SurrealityLabs/pi400-keyboard/README.md

# pi400-keyboard
A mechanical QWERTY keyboard for the Raspberry Pi 400
