SurrealityLabs/pi400-keyboard/10554668.png

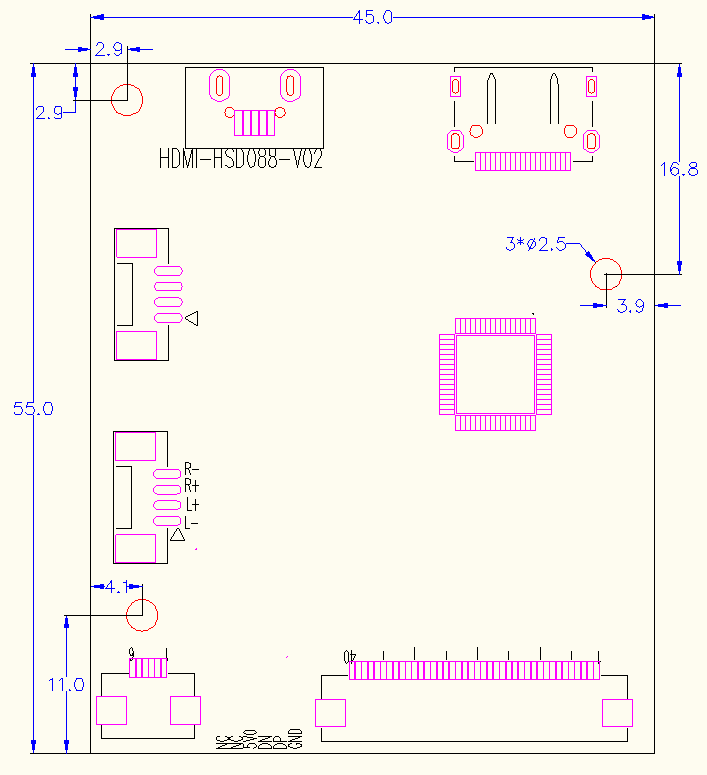
10554668.png
