SurrealityLabs/pi400-keyboard/keyboard-layout-xt.jpg

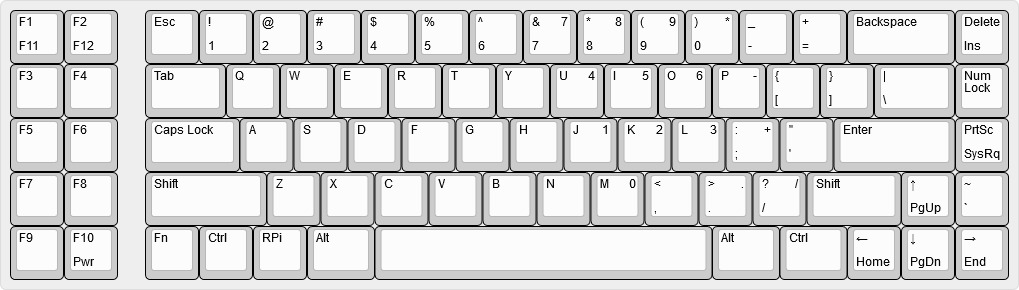
keyboard-layout-xt.jpg
