SurrealityLabs/pi400-keyboard/keyboard-layout.png

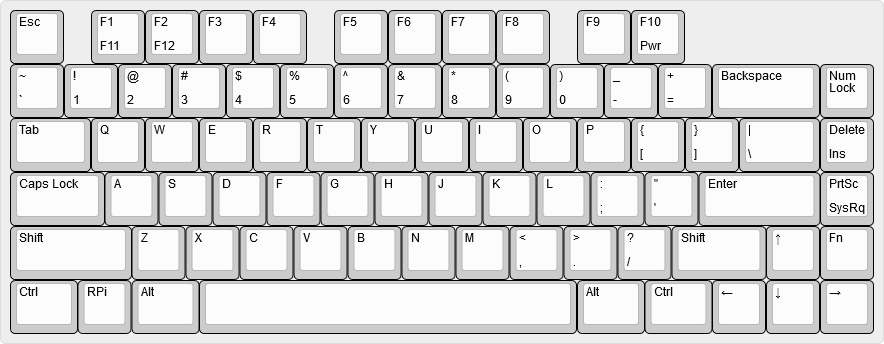
keyboard-layout.png
