SurrealityLabs/pi400-keyboard/pi400 keyboard matrix.png

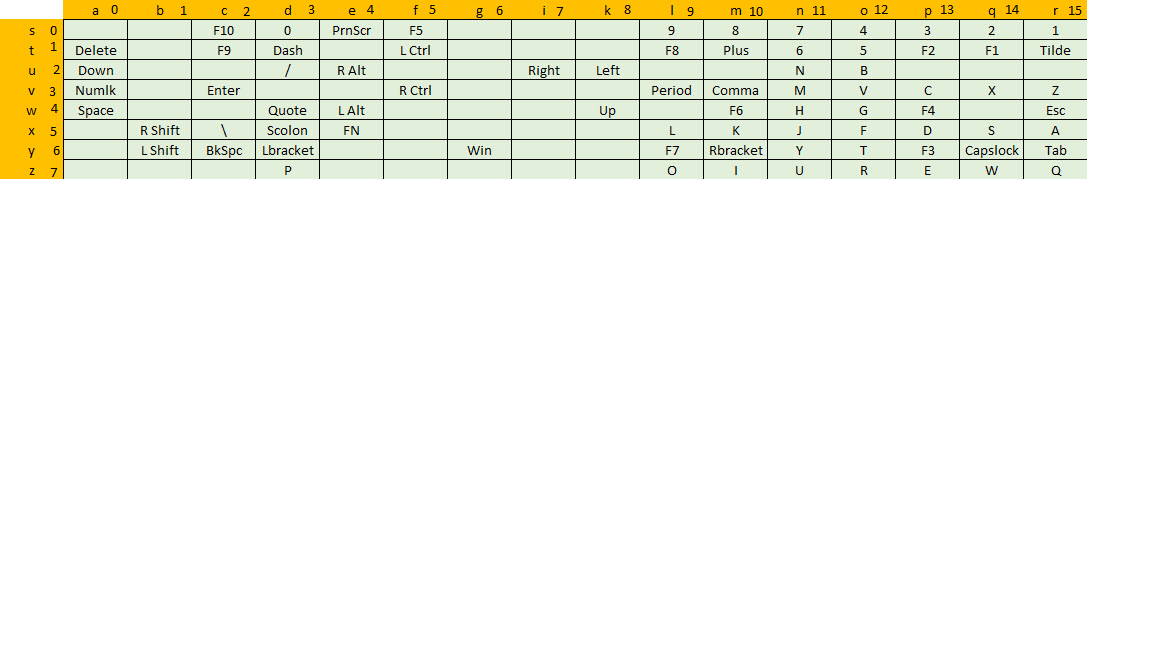
pi400 keyboard matrix.png
