SurrealityLabs/pi400-keyboard/s-l1600.jpg

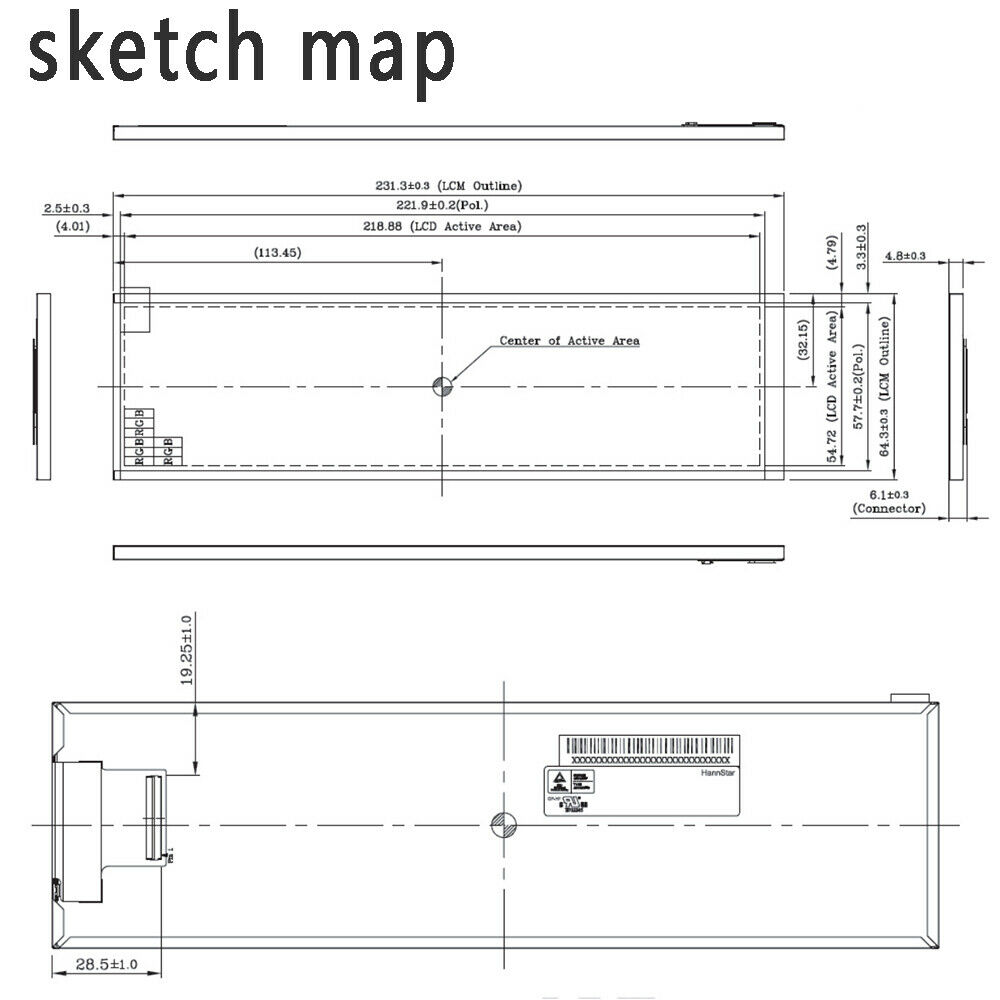
s-l1600.jpg
