SurrealityLabs/pi400-keyboard/keyboard-test/keyboard-test.kicad_pcb

## KiCad design keyboard-test/keyboard-test.kicad_pcb (2025-02-03)

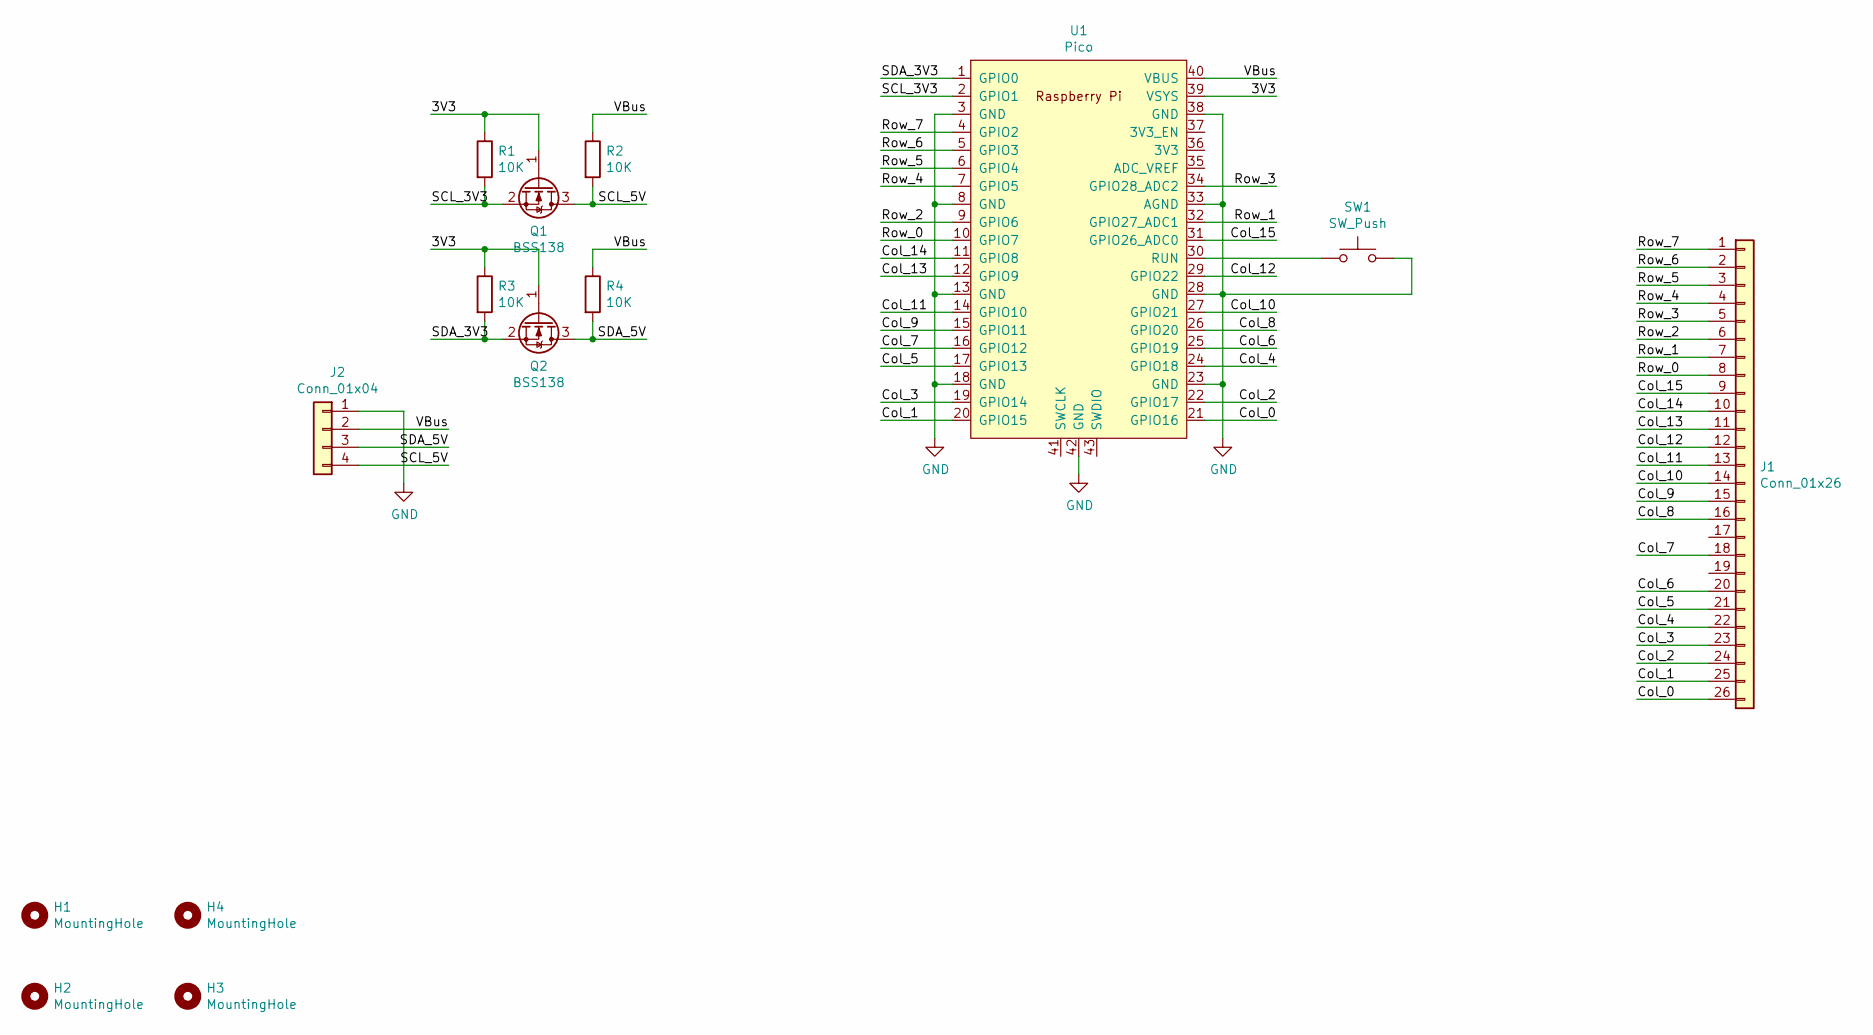
[picture p6: schematic keyboard-test.sch]

Parts:
H1, H2, H3, H4: MountingHole; MountingHole_3.2mm_M3_DIN965
J1: Conn_01x26; TE_2-84952-6_1x26-1MP_P1.0mm_Horizontal
J2: Conn_01x04; JST_PH_S4B-PH-SM4-TB_1x04-1MP_P2.00mm_Horizontal
Q1, Q2: BSS138; SOT-23
R1, R2, R3, R4: 10K; R_0603_1608Metric
SW1: SW_Push; SW_PUSH_6mm
U1: Pico; RPi_Pico_SMD_TH

Connections:
/3V3: Q1.1 (G), Q2.1 (G), R1.1, R3.1, U1.39 (VSYS)
/Col_0: J1.26, U1.21 (GPIO16)
/Col_1: J1.25, U1.20 (GPIO15)
/Col_2: J1.24, U1.22 (GPIO17)
/Col_3: J1.23, U1.19 (GPIO14)
/Col_4: J1.22, U1.24 (GPIO18)
/Col_5: J1.21, U1.17 (GPIO13)
/Col_6: J1.20, U1.25 (GPIO19)
/Col_7: J1.18, U1.16 (GPIO12)
/Col_8: J1.16, U1.26 (GPIO20)
/Col_9: J1.15, U1.15 (GPIO11)
/Col_10: J1.14, U1.27 (GPIO21)
/Col_11: J1.13, U1.14 (GPIO10)
/Col_12: J1.12, U1.29 (GPIO22)
/Col_13: J1.11, U1.12 (GPIO9)
/Col_14: J1.10, U1.11 (GPIO8)
/Col_15: J1.9, U1.31 (GPIO26_ADC0)
/Row_0: J1.8, U1.10 (GPIO7)
/Row_1: J1.7, U1.32 (GPIO27_ADC1)
/Row_2: J1.6, U1.9 (GPIO6)
/Row_3: J1.5, U1.34 (GPIO28_ADC2)
/Row_4: J1.4, U1.7 (GPIO5)
/Row_5: J1.3, U1.6 (GPIO4)
/Row_6: J1.2, U1.5 (GPIO3)
/Row_7: J1.1, U1.4 (GPIO2)
/SCL_3V3: Q1.2 (S), R1.2, U1.2 (GPIO1)
/SCL_5V: J2.4, Q1.3 (D), R2.2
/SDA_3V3: Q2.2 (S), R3.2, U1.1 (GPIO0)
/SDA_5V: J2.3, Q2.3 (D), R4.2
/VBus: J2.2, R2.1, R4.1, U1.40 (VBUS)
GND: J2.1, SW1.2, U1.3 (GND), U1.8 (GND), U1.13 (GND), U1.18 (GND), U1.23 (GND), U1.28 (GND), U1.33 (AGND), U1.38 (GND), U1.42 (GND)
unnamed: SW1.1, U1.30 (RUN)

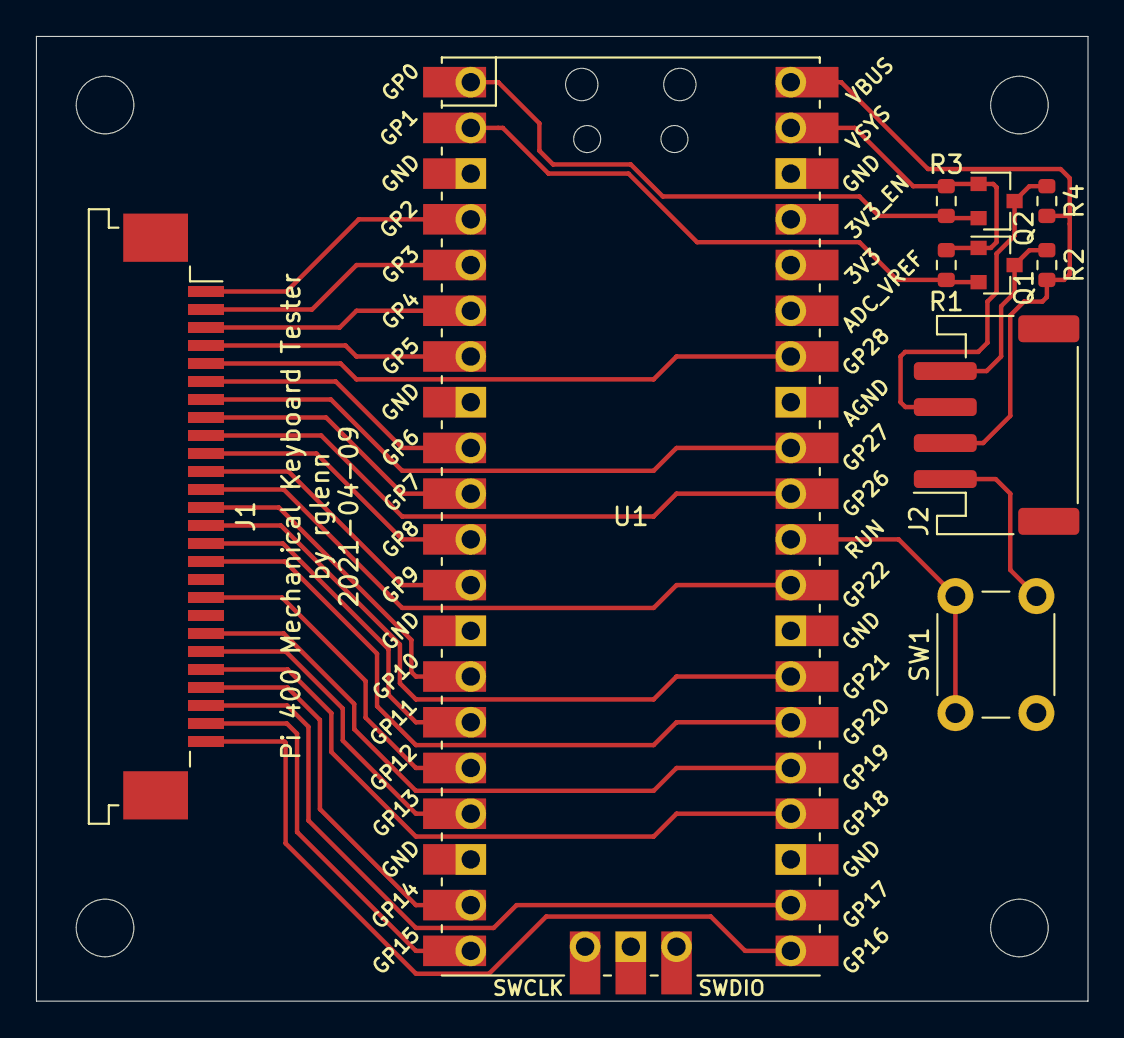
[picture p7: board keyboard-test.kicad_pcb from above]

Board: 2 copper layers, 58.4 x 53.6 mm, 14 parts (0 on the bottom side), 32 nets.
