SurrealityLabs/pi400-keyboard/keyboard-layout-tall/keyboard-layout-tall.kicad_pcb

## KiCad design keyboard-layout-tall/keyboard-layout-tall.kicad_pcb (2021-05-15)

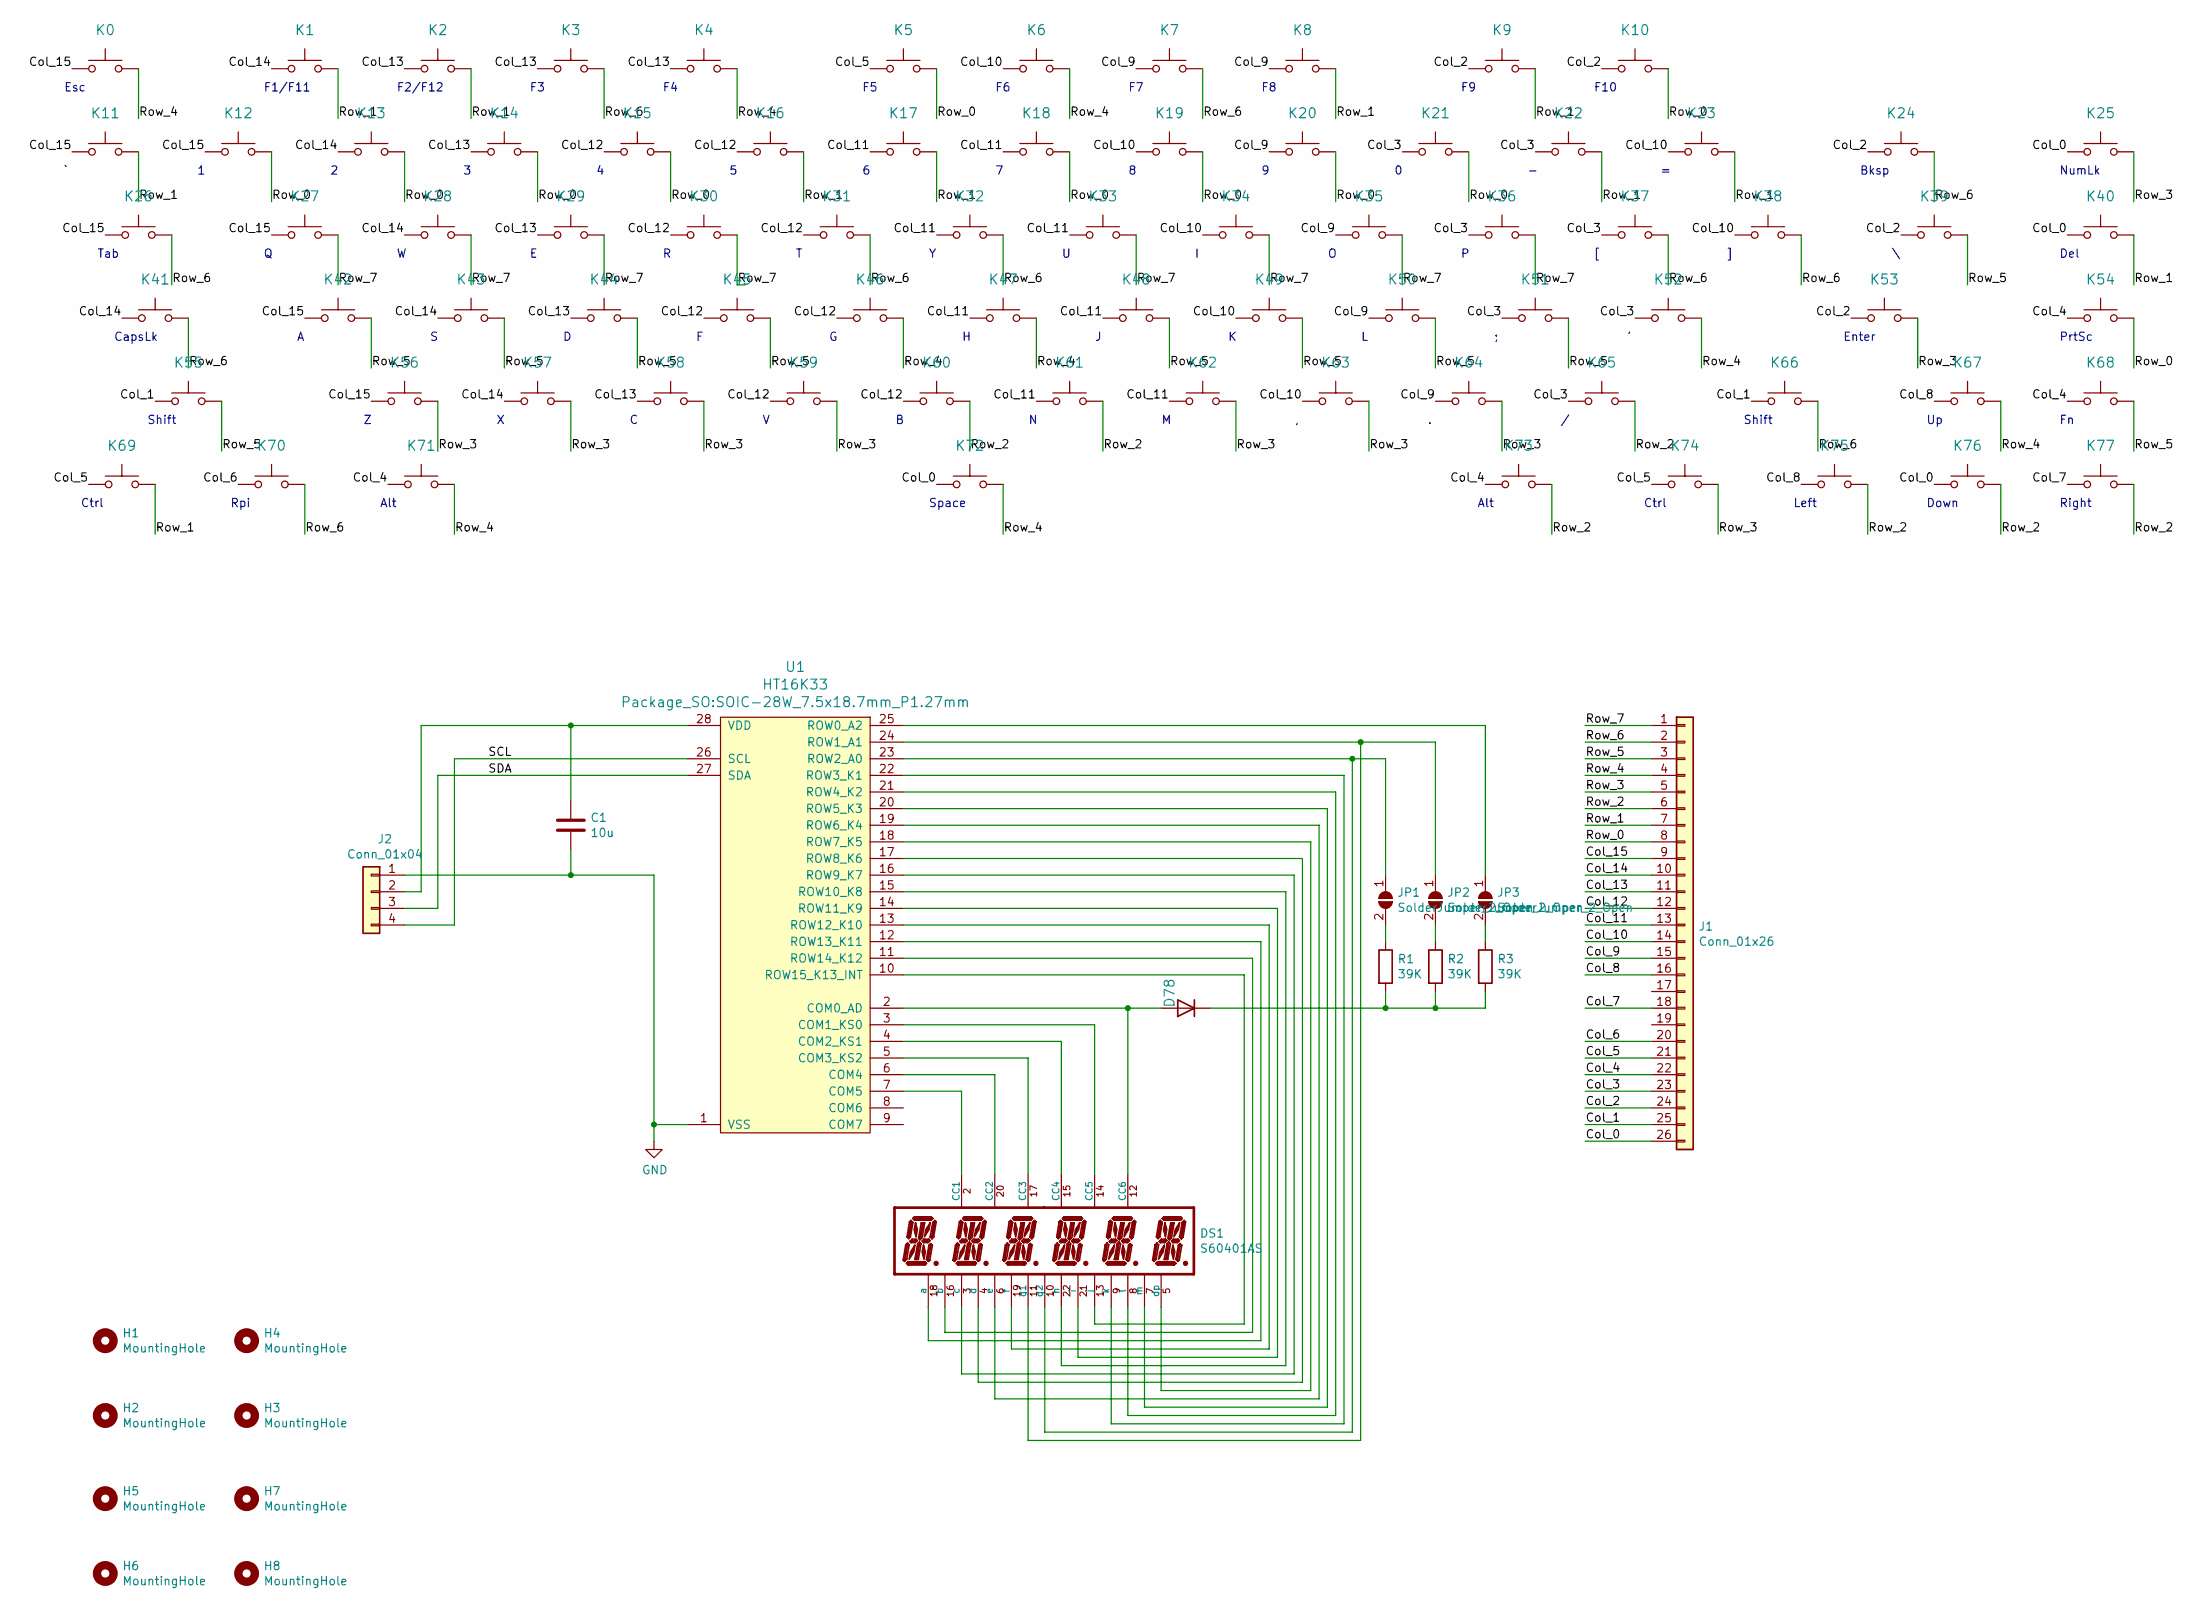
[picture p8: schematic keyboard-layout-tall.sch]

Parts:
C1: 10u; C_0805_2012Metric; LCSC C15850
D78: D; D_SOD-123F; LCSC C64898
DS1: S60401AS
H1, H2, H3, H4, H5, H6, H7, H8: MountingHole; MountingHole_3.2mm_M3_DIN965
J1: Conn_01x26; TE_2-84952-6_1x26-1MP_P1.0mm_Horizontal
J2: Conn_01x04; JST_PH_S4B-PH-SM4-TB_1x04-1MP_P2.00mm_Horizontal
JP1, JP2, JP3: SolderJumper_2_Open; SolderJumper-2_P1.3mm_Open_RoundedPad1.0x1.5mm
K0, K1, K2, K3, K4, K5, K6, K7, K8, K9, K10, K11, K12, K13, K14, K15, K16, K17, K18, K19, K20, K21, K22, K23, K25, K27, K28, K29, K30, K31, K32, K33, K34, K35, K36, K37, K38, K40, K42, K43, K44, K45, K46, K47, K48, K49, K50, K51, K52, K54, K56, K57, K58, K59, K60, K61, K62, K63, K64, K65, K67, K68, K70, K75, K76, K77: KEYSW; SW_Cherry_MX_1.00u_PCB
K24: KEYSW; SW_Cherry_MX_2.00u_PCB
K26, K39: KEYSW; SW_Cherry_MX_1.50u_PCB
K41, K66: KEYSW; SW_Cherry_MX_1.75u_PCB
K53, K55: KEYSW; SW_Cherry_MX_2.25u_PCB
K69, K71, K73, K74: KEYSW; SW_Cherry_MX_1.25u_PCB
K72: KEYSW; SW_Cherry_MX_7u_PCB
R1, R2, R3: 39K; R_0603_1608Metric; LCSC C23153
U1: HT16K33; SOIC-28W_7.5x18.7mm_P1.27mm

Connections:
/Col_0: J1.26, K25.1, K40.1, K72.1, K76.1
/Col_1: J1.25, K55.1, K66.1
/Col_2: J1.24, K9.1, K10.1, K24.1, K39.1, K53.1
/Col_3: J1.23, K21.1, K22.1, K36.1, K37.1, K51.1, K52.1, K65.1
/Col_4: J1.22, K54.1, K68.1, K71.1, K73.1
/Col_5: J1.21, K5.1, K69.1, K74.1
/Col_6: J1.20, K70.1
/Col_7: J1.18, K77.1
/Col_8: J1.16, K67.1, K75.1
/Col_9: J1.15, K7.1, K8.1, K20.1, K35.1, K50.1, K64.1
/Col_10: J1.14, K6.1, K19.1, K23.1, K34.1, K38.1, K49.1, K63.1
/Col_11: J1.13, K17.1, K18.1, K32.1, K33.1, K47.1, K48.1, K61.1, K62.1
/Col_12: J1.12, K15.1, K16.1, K30.1, K31.1, K45.1, K46.1, K59.1, K60.1
/Col_13: J1.11, K2.1, K3.1, K4.1, K14.1, K29.1, K44.1, K58.1
/Col_14: J1.10, K1.1, K13.1, K28.1, K41.1, K43.1, K57.1
/Col_15: J1.9, K0.1, K11.1, K12.1, K26.1, K27.1, K42.1, K56.1
/Row_0: J1.8, K5.2, K10.2, K12.2, K13.2, K14.2, K15.2, K18.2, K19.2, K20.2, K21.2, K54.2
/Row_1: J1.7, K1.2, K2.2, K8.2, K9.2, K11.2, K16.2, K17.2, K22.2, K23.2, K40.2, K69.2
/Row_2: J1.6, K60.2, K61.2, K65.2, K73.2, K75.2, K76.2, K77.2
/Row_3: J1.5, K25.2, K53.2, K56.2, K57.2, K58.2, K59.2, K62.2, K63.2, K64.2, K74.2
/Row_4: J1.4, K0.2, K4.2, K6.2, K46.2, K47.2, K52.2, K67.2, K71.2, K72.2
/Row_5: J1.3, K39.2, K42.2, K43.2, K44.2, K45.2, K48.2, K49.2, K50.2, K51.2, K55.2, K68.2
/Row_6: J1.2, K3.2, K7.2, K24.2, K26.2, K31.2, K32.2, K37.2, K38.2, K41.2, K66.2, K70.2
/Row_7: J1.1, K27.2, K28.2, K29.2, K30.2, K33.2, K34.2, K35.2, K36.2
/SCL: J2.4, U1.26 (SCL)
/SDA: J2.3, U1.27 (SDA)
GND: C1.2, J2.1, U1.1 (VSS)
unnamed: C1.1, J2.2, U1.28 (VDD)
unnamed: D78.1 (K), R1.2, R2.2, R3.2
unnamed: D78.2 (A), DS1.12 (CC6), U1.2 (COM0_AD)
unnamed: DS1.2 (CC1), U1.7 (COM5)
unnamed: DS1.3 (c), U1.16 (ROW9_K7)
unnamed: DS1.4 (d), U1.17 (ROW8_K6)
unnamed: DS1.5 (dp), U1.18 (ROW7_K5)
unnamed: DS1.6 (e), U1.19 (ROW6_K4)
unnamed: DS1.7 (m), U1.20 (ROW5_K3)
unnamed: DS1.8 (l), U1.21 (ROW4_K2)
unnamed: DS1.9 (k), U1.22 (ROW3_K1)
unnamed: DS1.10 (g2), JP1.1 (A), U1.23 (ROW2_A0)
unnamed: DS1.11 (g1), JP2.1 (A), U1.24 (ROW1_A1)
unnamed: DS1.13 (j), U1.10 (ROW15_K13_INT)
unnamed: DS1.14 (CC5), U1.3 (COM1_KS0)
unnamed: DS1.15 (CC4), U1.4 (COM2_KS1)
unnamed: DS1.16 (b), U1.11 (ROW14_K12)
unnamed: DS1.17 (CC3), U1.5 (COM3_KS2)
unnamed: DS1.18 (a), U1.12 (ROW13_K11)
unnamed: DS1.19 (f), U1.13 (ROW12_K10)
unnamed: DS1.20 (CC2), U1.6 (COM4)
unnamed: DS1.21 (i), U1.14 (ROW11_K9)
unnamed: DS1.22 (h), U1.15 (ROW10_K8)
unnamed: JP1.2 (B), R1.1
unnamed: JP2.2 (B), R2.1
unnamed: JP3.1 (A), U1.25 (ROW0_A2)
unnamed: JP3.2 (B), R3.1

Notes on the sheet:
Esc
F1/F11
F2/F12
F10
Bksp
NumLk
Tab
Del
CapsLk
Enter
PrtSc
Shift
Ctrl
Rpi
Alt
Space
Left
Down
Right

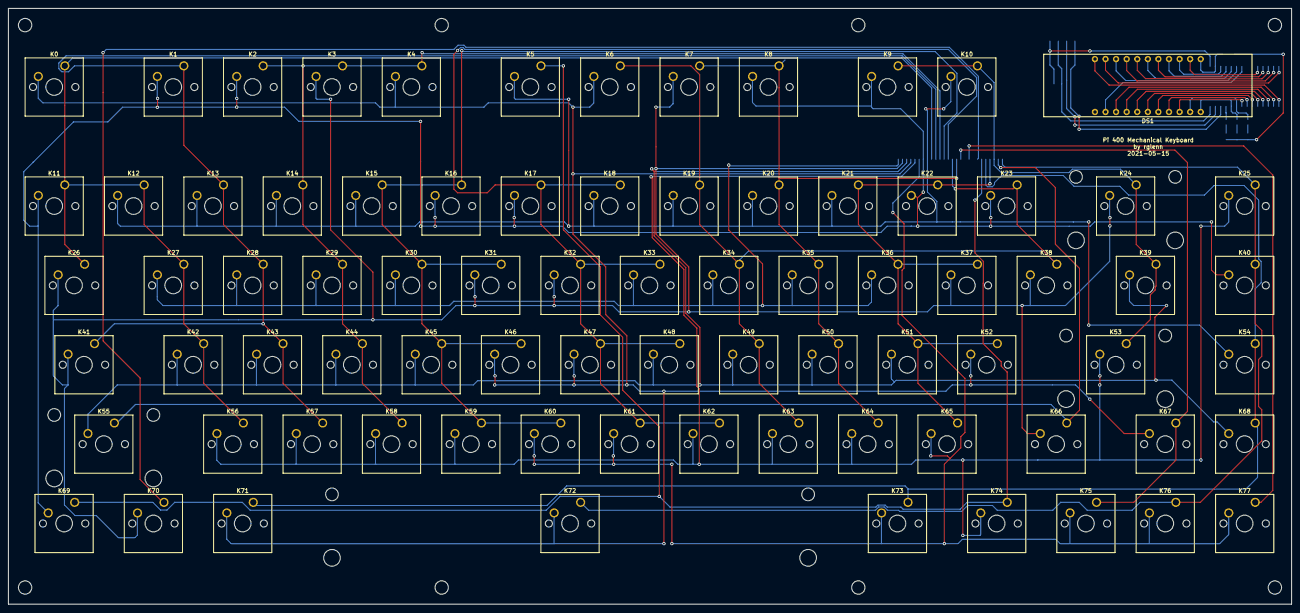
[picture p9: board keyboard-layout-tall.kicad_pcb from above]

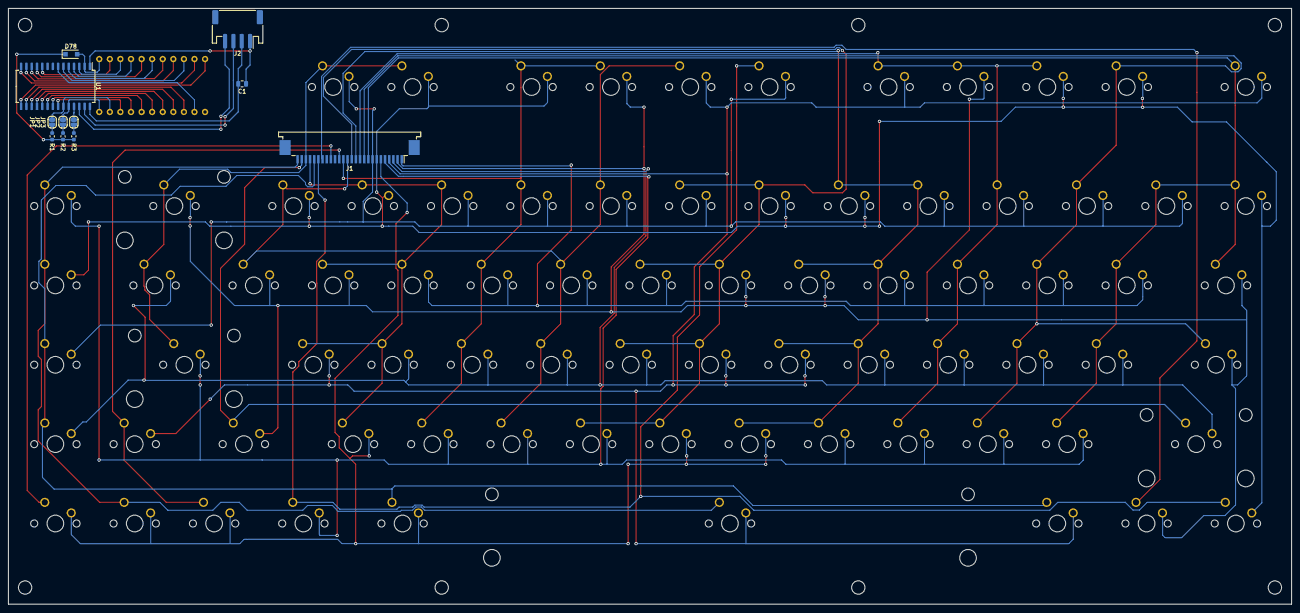
[picture p10: board keyboard-layout-tall.kicad_pcb from below]

Board: 2 copper layers, 308.0 x 143.0 mm, 98 parts (11 on the bottom side), 54 nets.
