SurrealityLabs/pi400-keyboard/(commit log)

2021-05-12 Adding first rev of keyboard. Diodes need to be removed and replaced with shorts - the Pi 400's keyboard controller doesn't register any keypresses when you have diodes in the matrix. Even Schottky d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
    [keyboard-layout-tall-B_Cu.gbl, keyboard-layout-tall-B_Mask.gbs, keyboard-layout-tall-B_Paste.gbp, keyboard-layout-tall-B_SilkS.gbo, keyboard-layout-tall-Edge_Cuts.gm1, keyboard-layout-tall-F_Cu.gtl, keyboard-layout-tall-F_Mask.gts, keyboard-layout-tall-F_Paste.gtp]
2021-05-15 Updated board to remove diodes. 2021-05-15 version should work right out of the box.
    [keyboard-layout-tall-B_Cu.gbl, keyboard-layout-tall-B_Mask.gbs, keyboard-layout-tall-B_Paste.gbp, keyboard-layout-tall-B_SilkS.gbo, keyboard-layout-tall-Edge_Cuts.gm1, keyboard-layout-tall-F_Cu.gtl, keyboard-layout-tall-F_Mask.gts, keyboard-layout-tall-F_Paste.gtp]
2025-02-03 Adding keyboard tester
    [keyboard-layout-tall-B_Cu.gbl, keyboard-layout-tall-B_Mask.gbs, keyboard-layout-tall-B_Paste.gbp, keyboard-layout-tall-B_SilkS.gbo, keyboard-layout-tall-Edge_Cuts.gm1, keyboard-layout-tall-F_Cu.gtl, keyboard-layout-tall-F_Mask.gts, keyboard-layout-tall-F_Paste.gtp]
